BooyahDev/Silica-Custom/four_cards/production/board_top.png

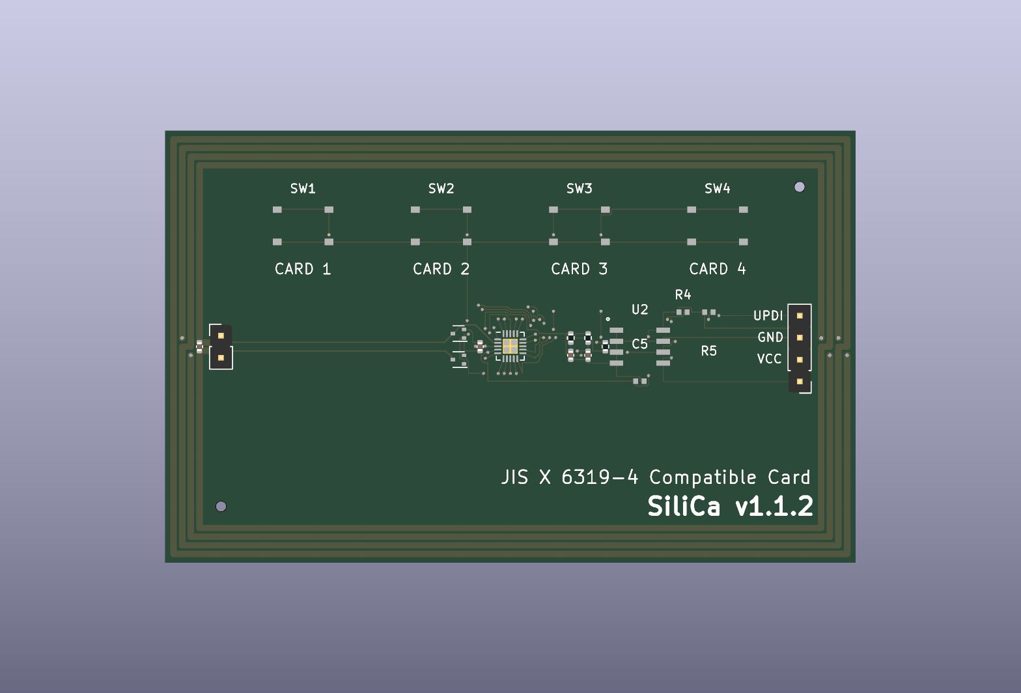
four_cards/production/board_top.png
