BooyahDev/Silica-Custom/four_cards/review/INITIAL_REVIEW.md

# 4枚切替 SiliCa 製造前レビュー

確認日: 2026-10-09 JST。判定: **現状のままの製造・実装発注は不可**。
回路・基板・ファームウェアは変更していません。検査報告と再現プログラムのみ追加しました。製造用Gerber/BOM/CPLは未生成です。

## 1. 部品仕様の追跡（元リポジトリにより解決）

2026-10-09追記: ユーザー提供の元リポジトリの production/bom.csv にLCSC番号があり、既存部品の値・型番を特定できました。前回の「部品値が不明で判断できない」という指摘は解消しました。詳細は `UPSTREAM_REVIEW.md` を参照してください。回路図のValue表示は依然R/Cのままです。

C1=47pF、C2=10nF、C3/C4=1nF、R1/R2=1kΩ、R3=510Ω、D1/D2=CBI BAT54ST、U1=ATTINY1616-MNRです。元BOMには単一参照の行に数量4/3/2が記載されており、数量の正規化が必要です。

追加8部品を含む全体BOM、JLCPCB調達可否、実装方向は未確定です。AE1/J1の実装有無も整理が必要です。元基板用Gerber/CPLは4枚切替版には使用できません。

## 2. ファームウェアの確定不具合

### P1: Echoコマンドで応答バッファを破壊

`src/1_1/src/application.cpp:443–445`。208バイトのresponseに、受信したLENを上限確認せずmemcpyしています。LEN=209、CODE=0xF0、command[2]=0のフレームで1バイトの範囲外書込みをAddressSanitizerで再現しました。LENは最大255なのでさらに広く破壊できます。応答停止・不正動作につながります。Echoを製品ビルドから除くか、コピー前に上限チェックが必要です。

再現: `echo_overflow_repro.cpp`、結果: `echo_overflow.log`。

```sh
clang++ -std=c++11 -fsanitize=address,undefined -I four_cards/src/1_1/src four_cards/review/echo_overflow_repro.cpp four_cards/src/1_1/src/application.cpp -o /tmp/silica-overflow
/tmp/silica-overflow
```

### P1: 受信デコード側にも配列上限チェックがない

`src/1_1/src/physical.cpp:278–280`。rx_bufは560バイト、commandは260バイトです。同期が先頭付近、受信長が559バイト等の場合、デコードループは最大約277バイトを書込み得ます。CRC検証より前に破壊が発生します。`index < CMD_BUF_SIZE` の保証と、不正長フレームの破棄が必要です。これはソース解析による指摘でRF入力からの実機再現は未実施です。

### P2: コマンドの内部長を検証しない

`application.cpp:73–93, 130–143, 175–190, 240–266, 431–450`。Pollingに正確な長さ検査がなく、Request Serviceはノード数分の入力の存在を確認せず、Readのブロックリストも残りバイト数を渡さず解析しています。短いがCRCが整合したフレームが来ると、LEN外に残った前フレームのデータ等を参照して処理し得ます。CRC整合だけではコマンド構造の正しさを保証できません。各コマンド長・リスト長を検証してください。

## 3. 基板と回路図のネイティブ検査

KiCad CLI 9.0.7で実施。`four_cards.kicad_pro` がないため既定のルールによる結果を含みます。件数をそのまま電気的不具合の件数と解釈しないでください。

- DRC: 675件（error 644、warning 31）、未接続0件。
- 間隔違反499件: 最小報告値0.1000mm、設定値0.2000mm。短絡の報告はありません。
- ビア関係: 穴径0.15mm/外径0.30mm/環幅0.075mmのため既定値違反が各44件。
- 穴対銅箔間隔13件、穴対穴間隔1件、同位置重複穴1件。
- 重複GNDビア位置: X=85.1mm、Y=62.85mm。
- ERC: 95件（error 3、warning 92）。電源駆動元未定義2件、U1 PB1（pin 13）未接続1件。受動整流電源のPWR_FLAGと未使用ピンのNo Connectを意図確認後に整理してください。これだけで電源が動かないとは断定できません。
- ライブラリ不一致・未登録、シルク重なり、グリッド外接続等もあります。

詳細は `drc.json` / `erc.json`。0.15mmビア穴自体はJLCPCBの公開能力範囲に含まれています。既定DRCを通すために全てを大型化する必要があるとは限りません。選択する層数、銅厚、基板厚、実装条件に合う製造ルールを確定し、プロジェクトに保存して再検査してください。重複穴は別途除去が必要です。
https://jlcpcb.com/capabilities/pcb-capabilities/

## 4. 正常確認できたことと未検証事項

- PlatformIOによるATtiny1616向けビルド: SUCCESS。RAM 1293/2048バイト、Flash 4415/16384バイト。ビルド成功は以下のメモリ破壊不具合がないことを意味しません。
- 既存 `tests/cards_test.cpp` をASan/UBSan付きで実行: PASS。ボタン組合せ、4バンク分離、読み書き、再選択、IDm変更、ボタン解除/変更時の応答抑制、保存失敗時の応答を確認。
- `tests/check_cad.py`: PASS。追加30パッドのネットとインスタンス対応を確認。DRCの代わりにはなりません。
- 24AA08のバンク指定、16バイト境界でのページ分割はデータシートの構成と整合。ただしホストテストはcards.cppをモックに置換しており、I2C波形や実際のEEPROMは検証していません。
https://ww1.microchip.com/downloads/en/DeviceDoc/24AA08-24LC08B-24FC08-8K-I2C-Serial-EEPROM-20001710N.pdf
- RF受動給電の余裕、EEPROM書込時の電圧降下、アンテナ同調、応答遅延、ボタン切替後の初回読出しは実機計測が必要です。読み込み処理中はリーダのフレームを受けられない設計です。
- fuses.cにはBOD等の定義がありますが、platformio.iniのuploadはFlash書込コマンドのみです。量産書込手順ではFlashとヒューズの両方の書込・読戻しを確認してください。ソースにFUSESがあるだけで実機に適用済みとは判断できません。
- 本設計は1個のMCUで4組のIDm等を保存して応答する構成です。実カード4枚のRF配線を切り替えるものではありません。実装されている非暗号化コマンドだけでは、認証を要する任意のFeliCaカードの代替にはなりません。

## 発注へ進む条件

元設計の部品値/型番は確認済み。次は バッファと入力長チェック修正・回帰検証 → 製造ルール確定とDRC/ERC整理 → 調達可能部品のBOMとCPL・方向確認 → 試作・給電/同調/対象リーダ試験、の順が妥当です。実機RF検証前に製造する場合は、動作保証済み製品ではなく検証用試作として扱う必要があります。
