BooyahDev/Silica-Custom/four_cards/review/REVIEW.md

# 製造前レビュー・修正結果

2026-10-09。初期指摘は`INITIAL_REVIEW.md`、修正前CADは`before_fix/`に保存。

- Echo応答の208バイト上限、受信デコードの配列上限、CRC検査前の最小長を追加。
- Polling、Request Service、Read/Writeの入力長とブロックリストを検査。書込ブロック全体の検証後に書込みを開始し、不正な後続ブロックによる部分更新を防止。
- 重複ビアを除去。穴対銅箔/穴対穴の実際の違反を配線移動で修正。JLCPCBの2層1oz仕様をKiCadプロジェクトに保存。
- 未使用PB1にNC、整流電源にPWR_FLAGを追加。部品値とフットプリントを実際の調達品に一致させ、ローカルライブラリを同梱。
- SW1〜4をXKB TS-1187A-B-A-Bに変更し、メーカー推奨ランド寸法と端子結線を確認。
- 基板/回路図全77ピンの接続関係が一致。DRCエラー0・未配線0、ERCエラー0。結果は`production/drc.json`、`production/erc.json`。
- 残るDRC警告2件は基板の治具穴とローカル部品ライブラリの差異。ERC警告75件はグリッド外端点72件と元設計のネット別名3件。接続一致検査と未配線検査で切断がないことを確認。
- ASan/UBSanで既存4バンク・ボタンテストに加え、LEN1〜255の各コマンドと不正リストを検査。PASS。
- ATtiny1616向けビルド成功。RAM1293/2048、Flash4599/16384。

製造用Gerber、1枚18部品のBOMとCPL、Flash HEXを生成。U1のCPLは元のカスタムフットプリントに合わせ270°。JLCPCBでの部品在庫、極性、実装位置確認は発注操作で実施する。

受動給電の余裕、EEPROM書込み時の電源降下、アンテナ同調、リーダ応答タイミングは未実測。受領後の試作評価が必要。本設計は4組のカード情報を保存する非暗号化応答装置で、実カード4枚を物理的に切り替える回路ではない。

## 費用削減版

ユーザー指示で決済は行わない。5枚製造・5枚実装、全11品番18部品/枚を維持し、最小ビアを0.3mm、ランド0.45mmへ変更。アンテナ銅箔を保持し、ICの引出しと信号・電源配線を引き直した。R1〜R3・C3/C4は右へ4mm移動しCPLを再出力。QFN露出パッド下に穴を設けず、表面配線でGND pin3へ接続。新設の穴をSMTランドから離して配置した。

変更後のネイティブDRCはエラー0・未配線0、残る警告は治具穴ライブラリ差異2件のみ。全77ピンの回路図接続一致と追加パッド検査もPASS。受領後のRF・給電評価は必要。

JLCPCBで標準ビア、レジストカバー、ケルビン検査なし、ENIG、エコノミック実装を試算し、基板5枚は3,493円（旧14,131円）。部品・実装込み8,167円、送料見積り込み約9,700円。個別アカウントの見積り記録はこのリポジトリに含めない。旧版カートと本版の製造データを混同しない。
