BooyahDev/Silica-Custom/four_cards/preview/back.png

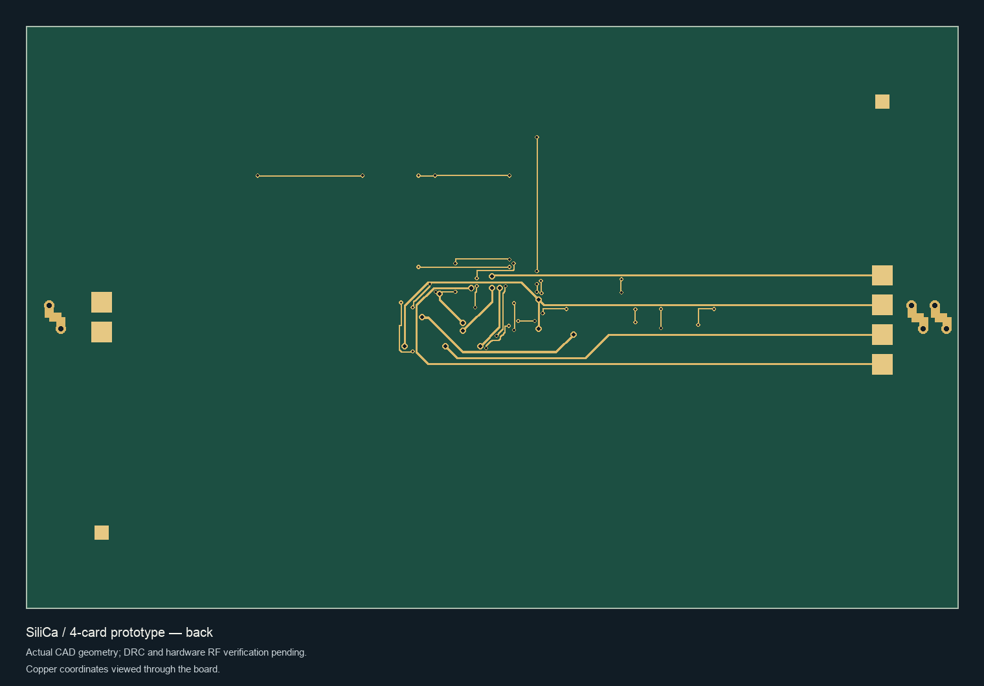
four_cards/preview/back.png
