BooyahDev/Silica-Custom/four_cards/preview/front.png

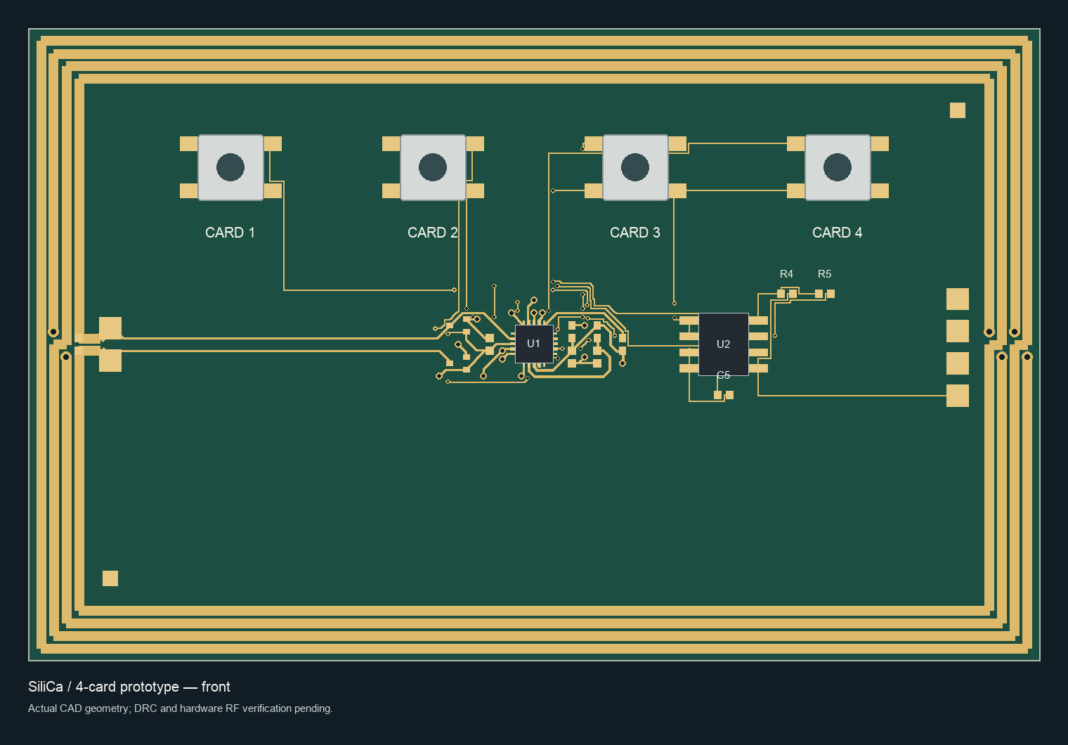
four_cards/preview/front.png
