BooyahDev/Silica-Custom/four_cards/production/BOM.csv

Comment | Designator | Footprint | LCSC Part #
47pF | C1 | 0402 | C1567
10nF | C2 | 0402 | C15195
1nF | C3,C4 | 0402 | C1523
100nF | C5 | 0402 | C1525
BAT54ST | D1,D2 | SOT-523 | C2919808
1k | R1,R2 | 0402 | C11702
510 | R3 | 0402 | C25123
10k | R4,R5 | 0402 | C25744
TS-1187A-B-A-B | SW1,SW2,SW3,SW4 | 6x3.5mm | C318884
ATTINY1616-MNR | U1 | VQFN-20-EP_3x3mm | C507118
24AA08T-I/SN | U2 | SOIC-8_3.9x4.9mm_P1.27mm | C2060935
