BooyahDev/Silica-Custom/four_cards/cad/four_cards/four_cards.kicad_pcb

## KiCad design four_cards/cad/four_cards/four_cards.kicad_pcb (2026-10-09)

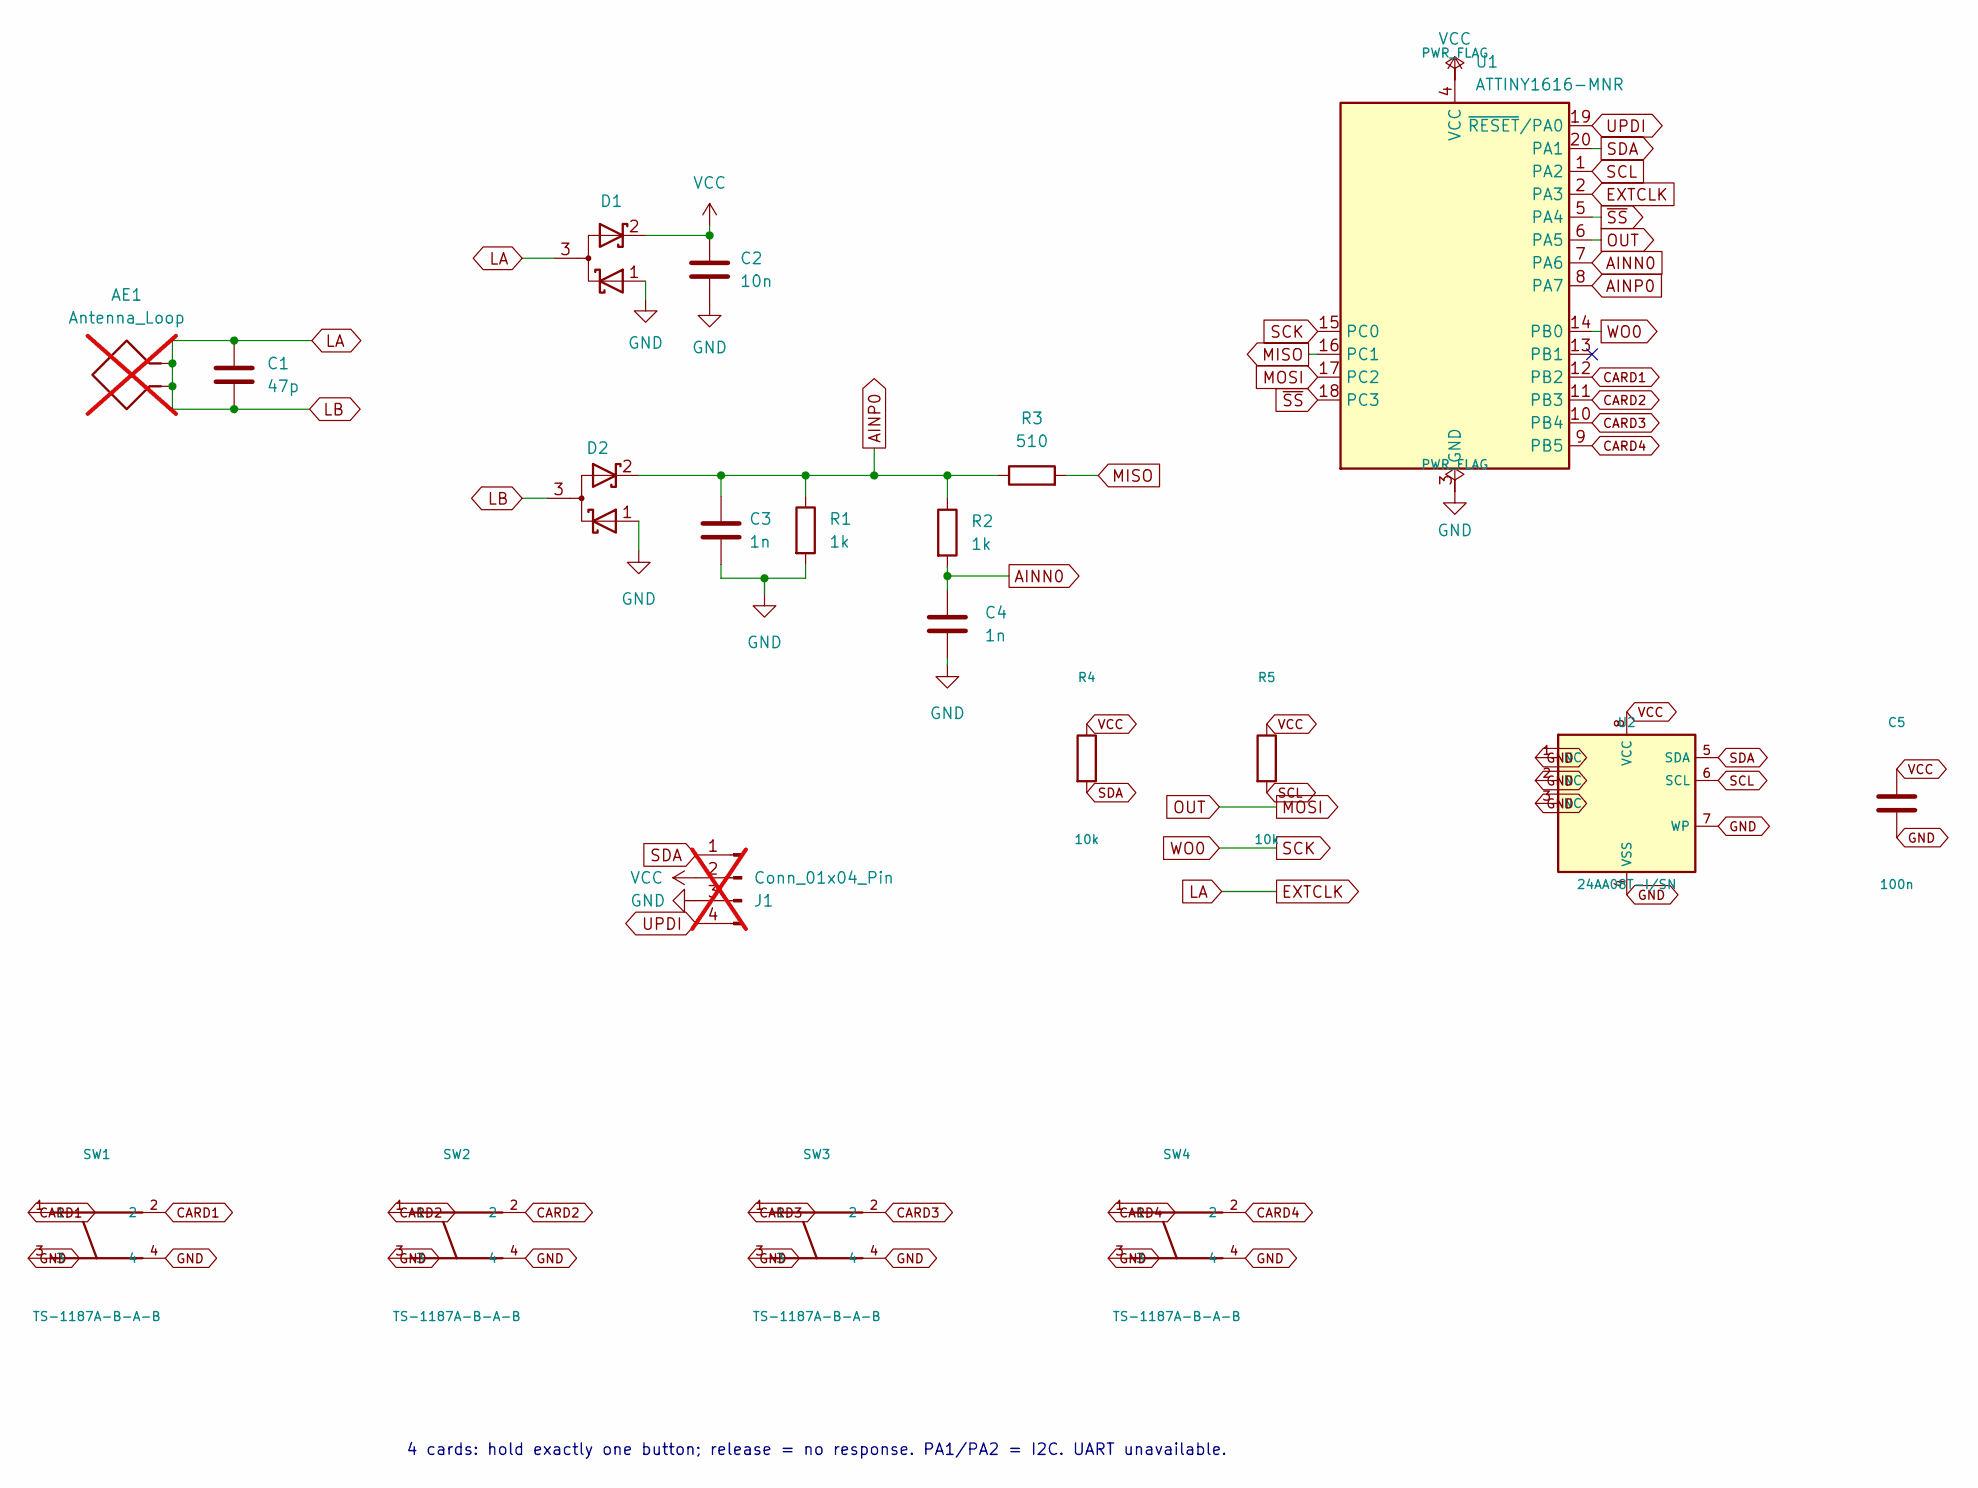
[picture p4: schematic four_cards.kicad_sch]

Parts:
AE1: Antenna_Loop; AE1; not fitted
C1: 47p; C1
C2: 10n; C2
C3: 1n; C3
C4: 1n; C4
C5: 100n; C5
D1: BAT54ST; D1
D2: BAT54ST; D2
J1: Conn_01x04_Pin; J1; not fitted
R1: 1k; R1
R2: 1k; R2
R3: 510; R3
R4: 10k; R4
R5: 10k; R5
SW1: TS-1187A-B-A-B; SW1
SW2: TS-1187A-B-A-B; SW2
SW3: TS-1187A-B-A-B; SW3
SW4: TS-1187A-B-A-B; SW4
U1: ATTINY1616-MNR; U1
U2: 24AA08T-I/SN; U2

Connections:
AINN0: C4.1, R2.2, U1.7 (PA6)
AINP0: C3.1, D2.2 (K), R1.1, R2.1, R3.1, U1.8 (PA7)
CARD1: SW1.1, SW1.2, U1.12 (PB2)
CARD2: SW2.1, SW2.2, U1.11 (PB3)
CARD3: SW3.1, SW3.2, U1.10 (PB4)
CARD4: SW4.1, SW4.2, U1.9 (PB5)
EXTCLK: AE1.1, AE1.2, C1.1, C1.2, D1.3 (A), D2.3 (A), U1.2 (PA3)
GND: C2.2, C3.2, C4.2, C5.2, D1.1 (K), D2.1 (K), J1.3, R1.2, SW1.3, SW1.4, SW2.3, SW2.4, SW3.3, SW3.4, SW4.3, SW4.4, U1.3 (GND), U1.21 (GND), U2.1 (NC), U2.2 (NC), U2.3 (NC), U2.4 (VSS), U2.7 (WP)
MISO: R3.2, U1.16 (PC1)
MOSI: U1.6 (PA5), U1.17 (PC2)
SCK: U1.14 (PB0), U1.15 (PC0)
SCL: R5.2, U1.1 (PA2), U2.6 (SCL)
SDA: J1.1, R4.2, U1.20 (PA1), U2.5 (SDA)
UPDI: J1.4, U1.19 (~RESET/PA0)
VCC: C2.1, C5.1, D1.2 (K), J1.2, R4.1, R5.1, U1.4 (VCC), U2.8 (VCC)
~SS: U1.5 (PA4), U1.18 (PC3)

Notes on the sheet:
4 cards: hold exactly one button; release = no response. PA1/PA2 = I2C. UART unavailable.

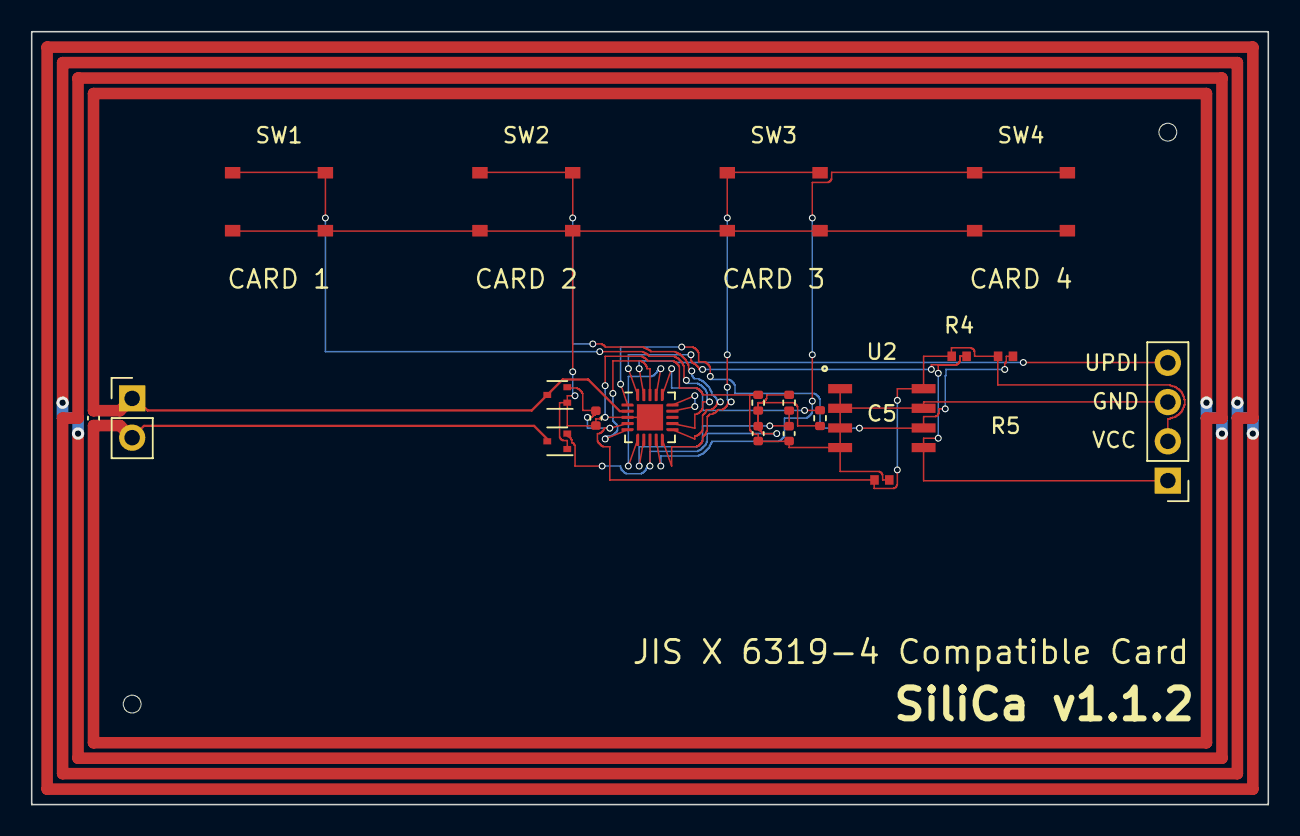
[picture p5: board four_cards.kicad_pcb from above]

Board: 2 copper layers, 80.0 x 50.0 mm, 20 parts (0 on the bottom side), 16 nets.
